MatAtBread/FreeHouse-TRV-1.0/hardware/TRV1-BH/Spacer-retainer-plug.step

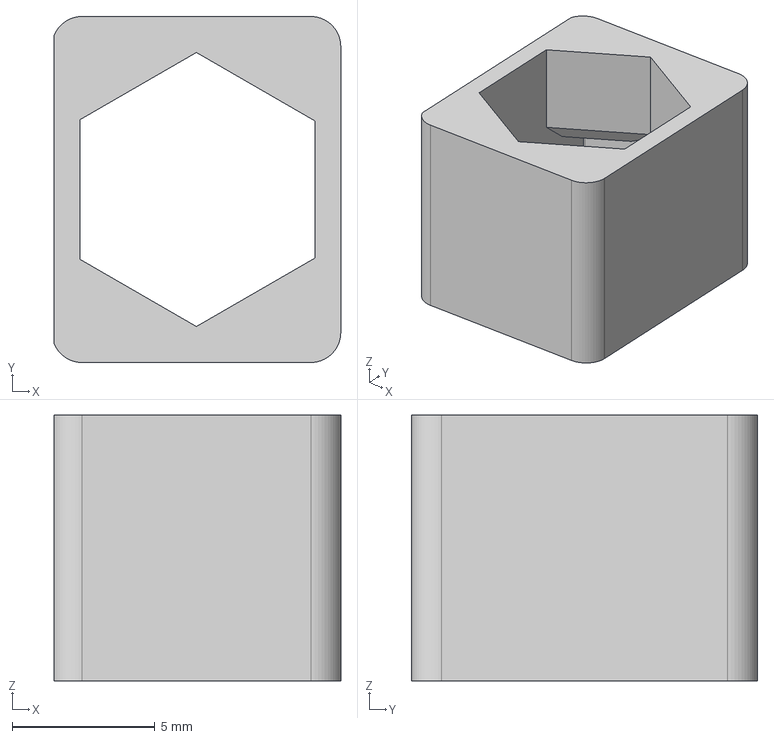
[picture p1: CAD file, 2026-05-30]
hardware/TRV1-BH/Spacer-retainer-plug.step
10.0 x 12.1 x 9.30 mm
