MatAtBread/FreeHouse-TRV-1.0/hardware/TRV1-CR123/Base p10-h1-r2-steel.step

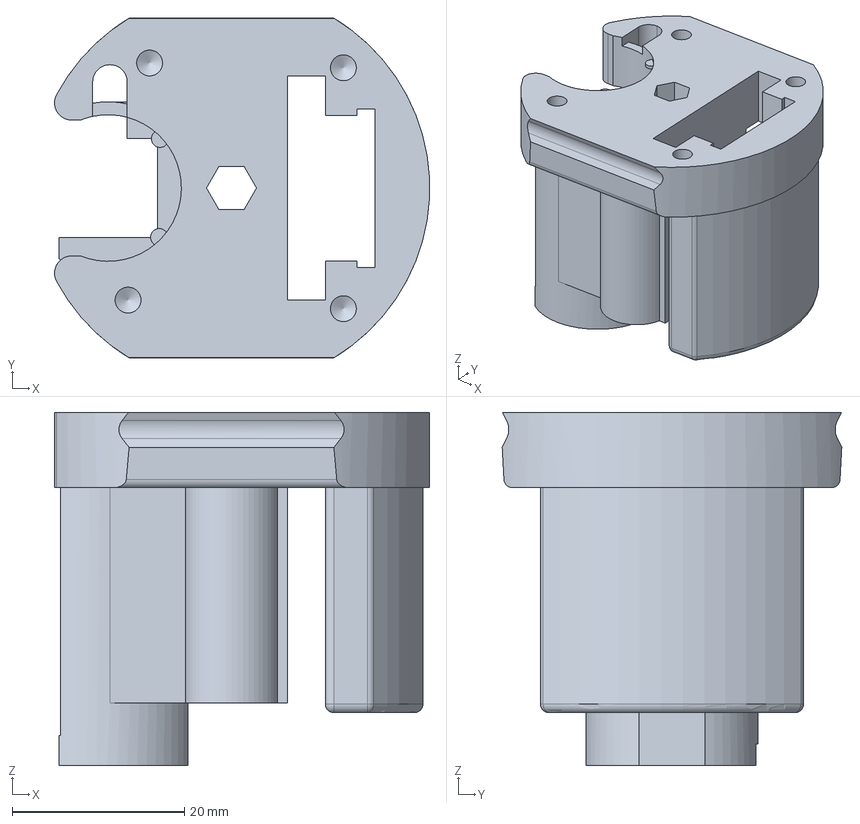
[picture p2: CAD file, 2025-10-17]
hardware/TRV1-CR123/Base p10-h1-r2-steel.step
43.5 x 39.4 x 41.0 mm
