MatAtBread/FreeHouse-TRV-1.0/hardware/TRV1-BH/Base.step

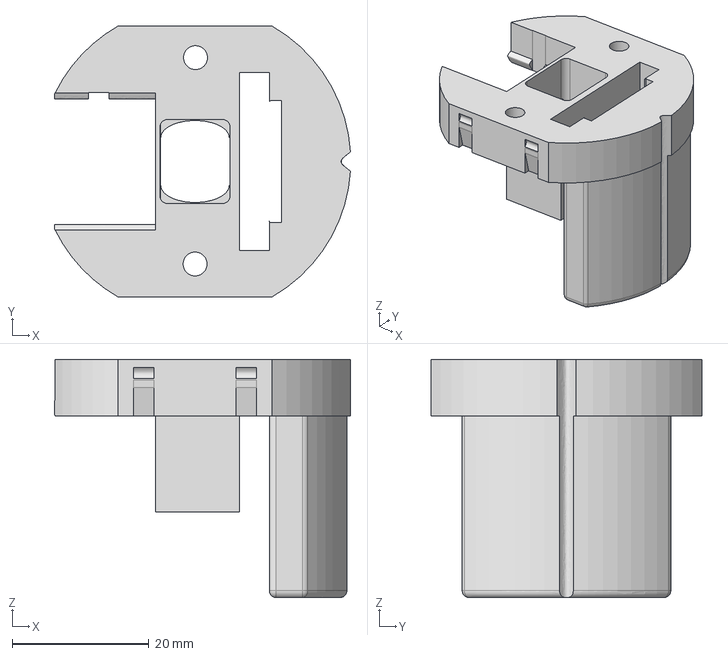
[picture p3: CAD file, 2026-05-30]
hardware/TRV1-BH/Base.step
43.3 x 39.6 x 34.9 mm
