MatAtBread/FreeHouse-TRV-1.0/hardware/TRV1-CR123/Case-r2.step

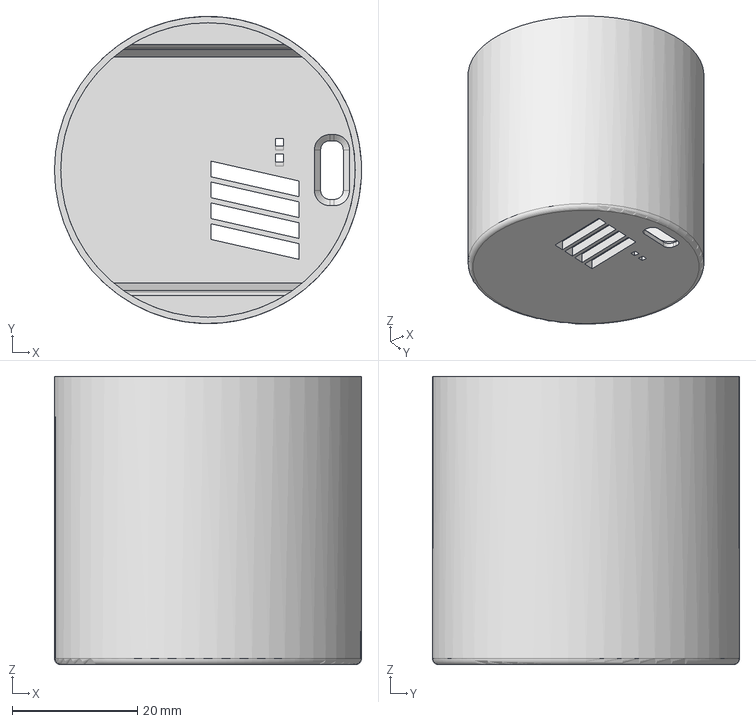
[picture p4: CAD file, 2025-05-19]
hardware/TRV1-CR123/Case-r2.step
49.0 x 49.0 x 46.0 mm
