MatAtBread/FreeHouse-TRV-1.0/hardware/TRV1-BH/Pin Coupler (2).step

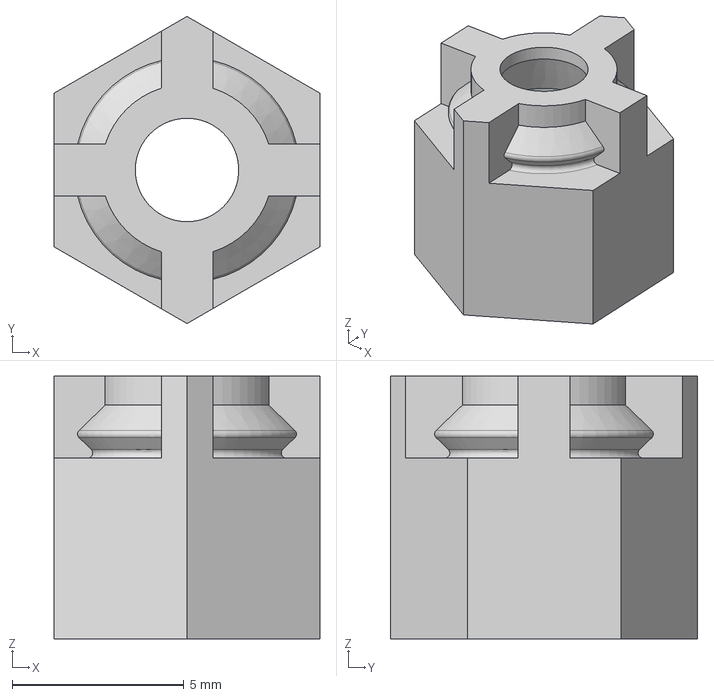
[picture p5: CAD file, 2026-05-30]
hardware/TRV1-BH/Pin Coupler (2).step
7.74 x 8.94 x 7.65 mm
