MatAtBread/FreeHouse-TRV-1.0/hardware/TRV1-BH/Batt holder.step

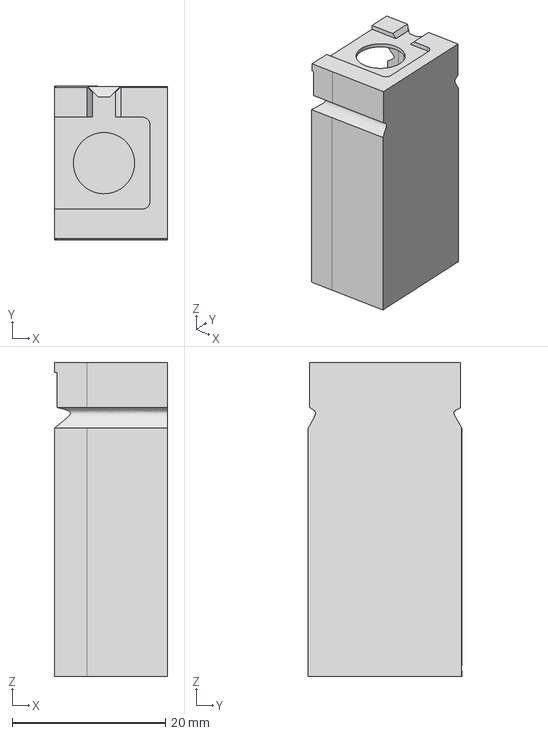
[picture p6: CAD file, 2026-05-30]
hardware/TRV1-BH/Batt holder.step
14.8 x 20.0 x 41.0 mm
