MatAtBread/FreeHouse-TRV-1.0/hardware/TRV1-BH/Valve coupler.step

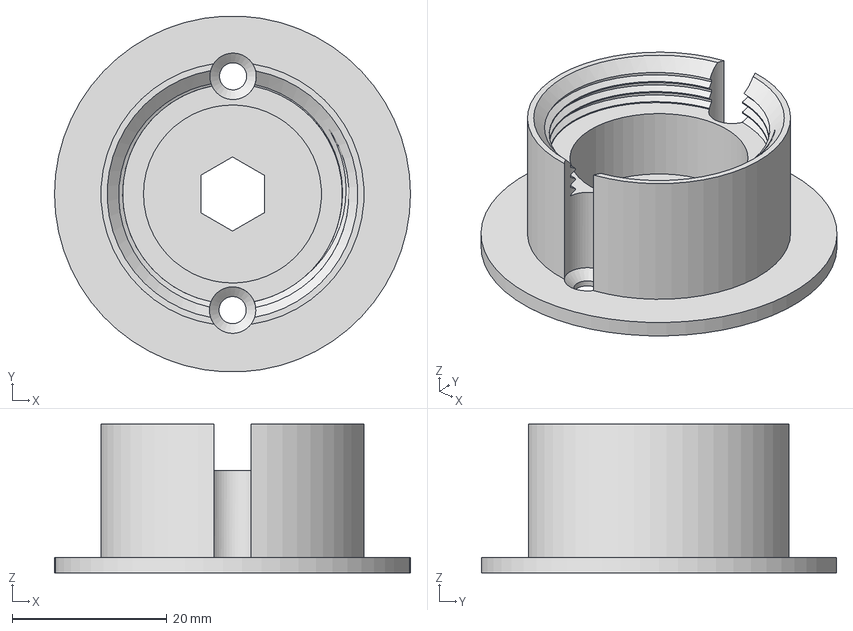
[picture p7: CAD file, 2026-05-30]
hardware/TRV1-BH/Valve coupler.step
46.0 x 45.9 x 19.2 mm
