MatAtBread/FreeHouse-TRV-1.0/hardware/TRV1-AA2/Pin Coupler.step

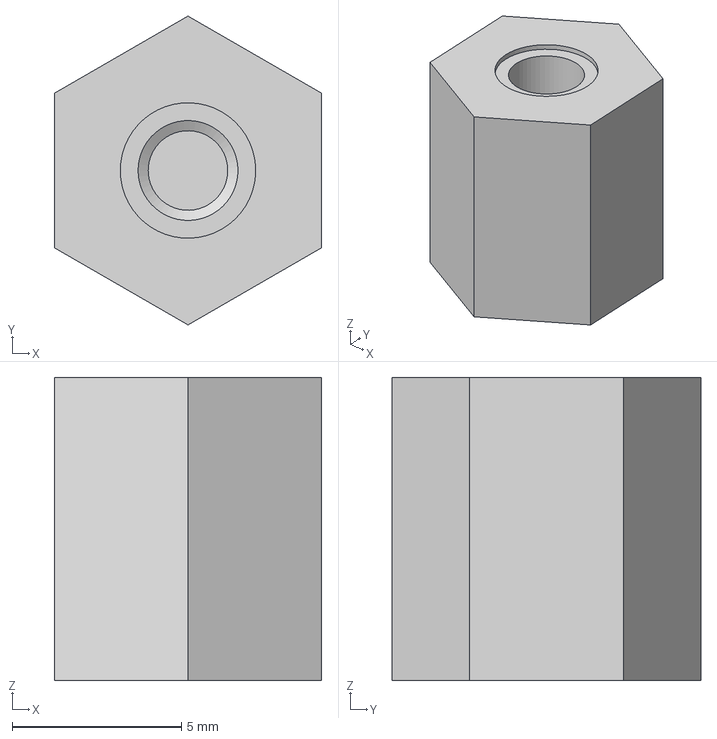
[picture p8: CAD file, 2026-04-09]
hardware/TRV1-AA2/Pin Coupler.step
7.90 x 9.12 x 8.95 mm
