MatAtBread/FreeHouse-TRV-1.0/hardware/TRV1-BH/Pin Couipler (2) cap.step

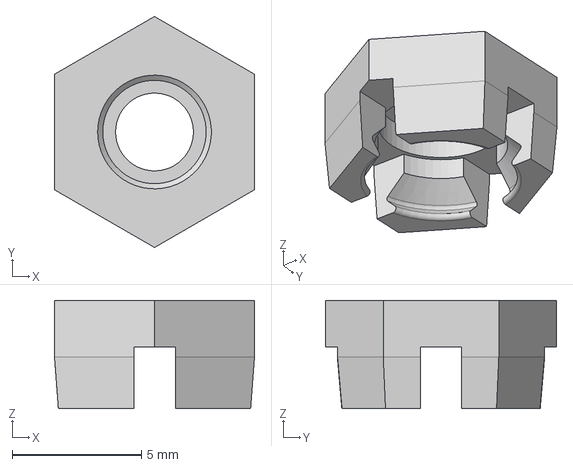
[picture p9: CAD file, 2026-05-30]
hardware/TRV1-BH/Pin Couipler (2) cap.step
7.74 x 8.94 x 4.19 mm
