MatAtBread/FreeHouse-TRV-1.0/hardware/TRV1-AA2/Case.step

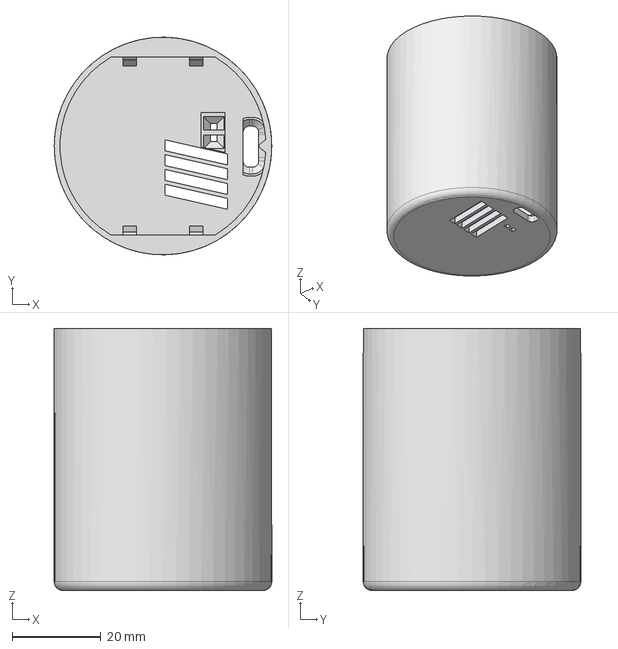
[picture p10: CAD file, 2026-04-09, an earlier design]
hardware/TRV1-AA2/Case.step
49.0 x 49.0 x 59.0 mm
