MatAtBread/FreeHouse-TRV-1.0/hardware/TRV1-AA2/Base.step

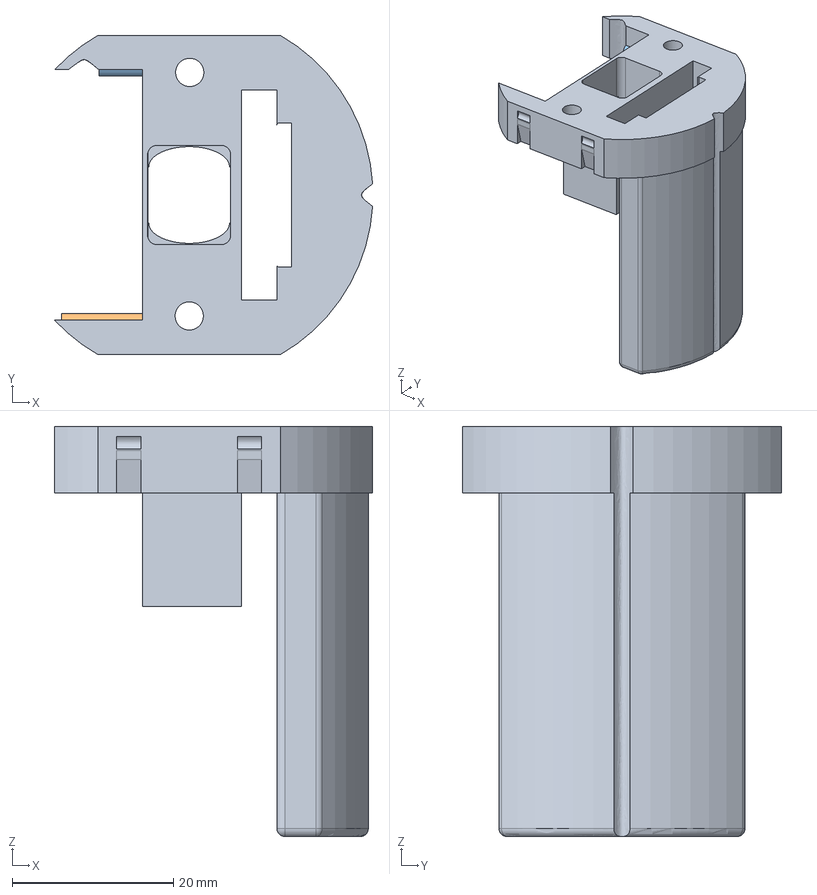
[picture p11: CAD file, 2026-04-09, an earlier design]
hardware/TRV1-AA2/Base.step
39.5 x 39.6 x 50.9 mm
