MatAtBread/FreeHouse-TRV-1.0/hardware/TRV1-AA2/Batt holder.step

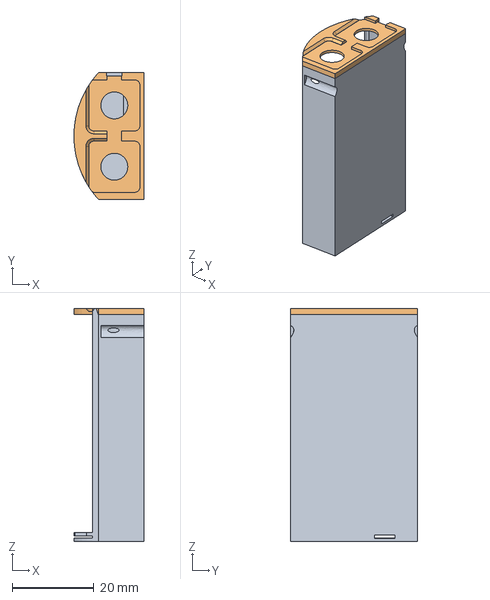
[picture p12: CAD file, 2026-04-09, an earlier design]
hardware/TRV1-AA2/Batt holder.step
17.2 x 31.0 x 57.0 mm
