MatAtBread/FreeHouse-TRV-1.0/(list of files, cad)

Other CAD files:
hardware/TRV1-CR123/Case-r1.step
hardware/TRV1-BH/Case.step
hardware/TRV1-NS/Spacer-retainer-plug.step
hardware/TRV1-NS/Valve coupler.step
hardware/TRV1-AA2/Valve coupler.step
hardware/TRV1-NS/Batt holder.step
hardware/TRV1-AA2/Spacer-retainer-plug.step
hardware/TRV1-NS/Case.step
