MatAtBread/FreeHouse-TRV-1.0/hardware/Schematic 3_2.pdf

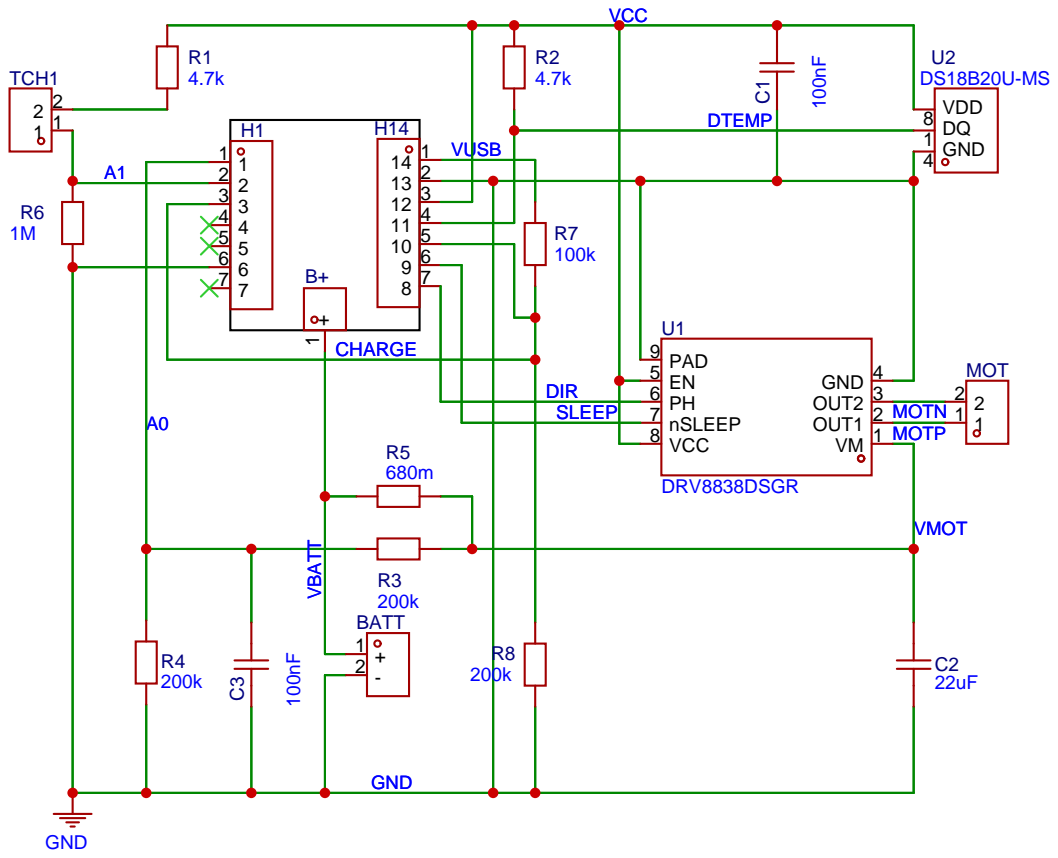
[picture p13: page 1]
