MatAtBread/FreeHouse-TRV-1.0/hardware/Schematic 3_1.pdf

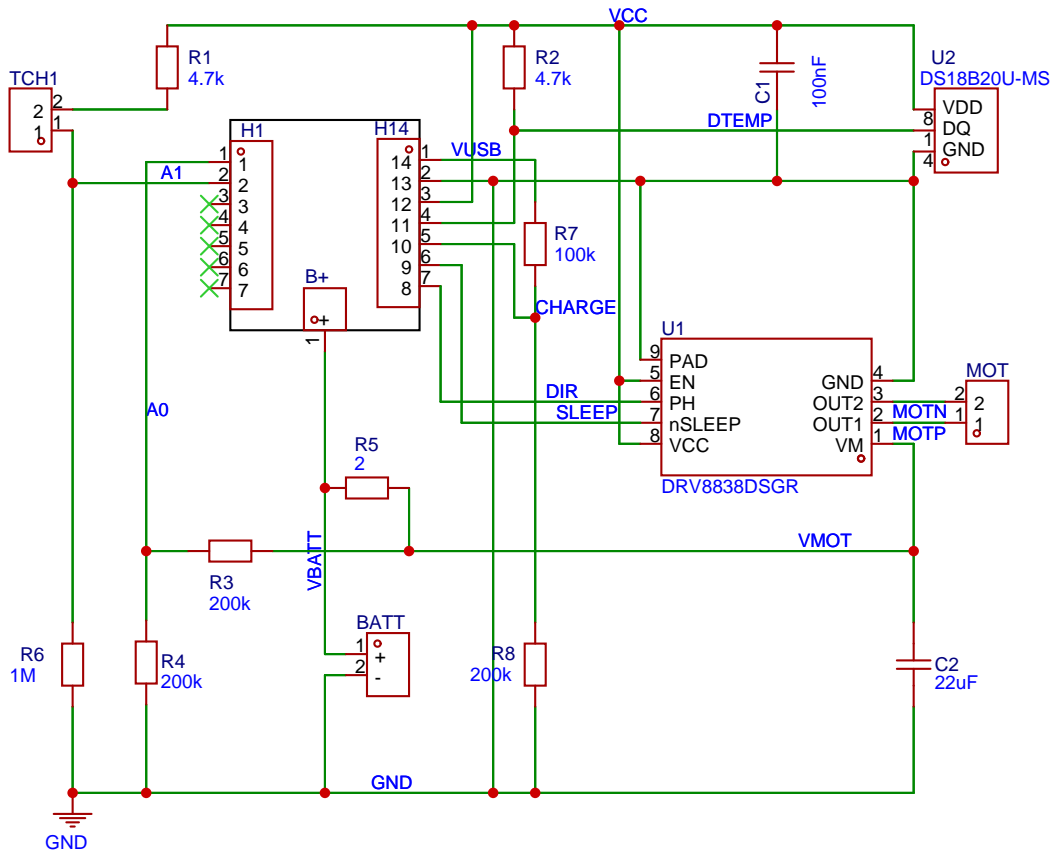
[picture p14: page 1]
