MatAtBread/FreeHouse-TRV-1.0/main/main.cpp

// the setup function runs once when you press reset or power the board

#include "gpio.hpp"
#include "esp_app_desc.h"
#include "esp_netif.h"
#include "esp_sleep.h"
#include "net/esp-now.hpp"
#include "nvs_flash.h"
#include "pins.h"
#include "src/CaptiveWifi.h"
#include "src/TouchButton.hpp"
#include "src/WithTask.hpp"
#include "src/trv-state.h"
#include "trv.h"

extern "C" {
const char *TAG = "TRV";
}

static RTC_DATA_ATTR int messageCheckCount = 0;
static RTC_DATA_ATTR int wakeCount = 0;
char versionDetail[110] = {0};
#define RECALIBRATE_PERIOD_SECS (24 * 3600 * 25) // Recalibrate every 25 days

uint32_t woken() {
  Trv trv; // Loads static state from FS
  if (trv.flatBattery() && !trv.is_charging()) {
    ESP_LOGW(TAG, "Battery exhausted");
    // Skip tidy up - we're dead
    esp_sleep_enable_ext1_wakeup(1ULL << TOUCH_PIN, ESP_EXT1_WAKEUP_ANY_HIGH);
    return 0x7FFFFFFF;
  }

  ESP_LOGI(TAG, "Build: %s. Wake: %d reset: %d count: %d", versionDetail,
           esp_sleep_get_wakeup_cause(), esp_reset_reason(), wakeCount);

  if (wakeCount > RECALIBRATE_PERIOD_SECS / trv.getConfig().sleep_time) {
    ESP_LOGI(TAG,
             "Recalibration period reached (%d secs), starting calibration",
             RECALIBRATE_PERIOD_SECS);
    trv.calibrate();
    wakeCount = 0;
  }

  EspNet net; // Start Wi-Fi based on Trv state (loaded above)

  uint32_t dreamSecs = 1;
  TouchButton touchButton;
  if (!trv.deviceName()[0] || touchButton.pressed() == PRESSED) {
    ESP_LOGI(TAG, "Touch button pressed / device name '%s'", trv.deviceName());
    CaptivePortal portal(&trv, trv.deviceName());
    switch (portal.exitStatus) {
    case exit_status_t::CALIBRATE:
      trv.calibrate();
      break;
    case exit_status_t::TEST_MODE:
      trv.testMode(touchButton);
      break;
    case exit_status_t::POWER_OFF:
      ESP_LOGI(TAG, "Power off requested");
      dreamSecs = 0x7FFFFFFF; // Forever
      EspNet::unpair();
      break;
    case exit_status_t::CLOSED:
    case exit_status_t::NONE:
    case exit_status_t::TIME_OUT:
      break;
    }
  } else {
    net.checkMessages(&trv);
    // We do this at 0 so it always sets the mode after a hard restart
    if (messageCheckCount == 0) {
      // Every 60 seconds re-set the system-mode to ensure the TRV acts to
      // correct things like motor time-outs or temperature changes
      trv.setSystemMode(trv.getConfig().system_mode);
    }

    int checkEvery = 60 / trv.getConfig().sleep_time;
    if (++messageCheckCount >= checkEvery)
      messageCheckCount = 0;

    dreamSecs = trv.getConfig().sleep_time;
  }

  while (WithTask::waitForAllTasks(1234) == TIMEOUT) {
    if (net.wait(1) != TIMEOUT) {
      net.sendStateToHub(&trv);
    }
  }
  net.sendStateToHub(&trv);

  if (trv.requiresNetworkControl()) {
    // We have to do this incase there's a pending OTA request executed by the
    // TRV desctructor The reason we don't always do this is to save power/time
    // when not needed
    net.deinit();
  }

  uint64_t ext1WakeMask = (1ULL << TOUCH_PIN);
  if (!trv.is_charging()) {
    // Ideally, we'd wake on CHARGING changed, but in the current h/w this is
    // not an RTC_GPIO. On Rev3.2, the CHARGING pin is connected to GPIO2, so we
    // can use that if we're not alreday charghing (if we are, it would wake
    // immediately)
    ext1WakeMask |= (1ULL << 2);
  }

  // Prepare to sleep. Wake on touch or timeout
  // Ideally, we'd wake on CHARGING changed, but in the current h/w this is not
  // an RTC_GPIO. On Rev3.2, the CHARGIBG pin is connected to GPIO2, so we can
  // use that.
  esp_sleep_enable_ext1_wakeup(ext1WakeMask, ESP_EXT1_WAKEUP_ANY_HIGH);

  return dreamSecs;
}

extern "C" void app_main() {
  GPIO::pinMode(LED_BUILTIN, OUTPUT);
  GPIO::digitalWrite(LED_BUILTIN, false);

  wakeCount += 1;

  const auto app = esp_app_get_description();
  snprintf((char *)versionDetail, sizeof versionDetail, "%s %s %s",
           app->version, app->date, app->time);

  esp_err_t ret = nvs_flash_init();
  if (ret == ESP_ERR_NVS_NO_FREE_PAGES ||
      ret == ESP_ERR_NVS_NEW_VERSION_FOUND) {
    ESP_ERROR_CHECK(nvs_flash_erase());
    ret = nvs_flash_init();
  }
  ESP_ERROR_CHECK(ret);
  ESP_ERROR_CHECK(esp_netif_init());
  ESP_ERROR_CHECK(esp_event_loop_create_default());

  auto dreamSecs = woken();

  GPIO::digitalWrite(LED_BUILTIN, true);
  GPIO::pinMode(TOUCH_PIN, INPUT);

  esp_sleep_enable_timer_wakeup(dreamSecs * 1000000ULL);
  ESP_LOGW(TAG,
           FREEHOUSE_MODEL
           " (build %s) device '%s' dbg=0x%04x. Deep sleep %u secs\n",
           versionDetail, Trv::deviceName(), debugFlag(DEBUG_ALL), dreamSecs);

  esp_deep_sleep_start();
}
