MatAtBread/FreeHouse-TRV-1.0/main/src/board.cpp

#include "board.h"
#include "gpio.hpp"

#include "nvs.h"

esp_err_t dev_wifi_init(wifi_init_config_t *config) {
    GPIO::pinMode(3, OUTPUT);
    GPIO::pinMode(14, OUTPUT);
    GPIO::digitalWrite(3, 0);
    GPIO::digitalWrite(14, 0);

    // If NVS is not initialized, disable NVS in WiFi config to prevent errors
    nvs_handle_t check_handle;
    if (nvs_open("storage", NVS_READONLY, &check_handle) == ESP_ERR_NVS_NOT_INITIALIZED) {
        ((wifi_init_config_t*)config)->nvs_enable = 0;
    } else {
        nvs_close(check_handle);
    }

    auto err = esp_wifi_init(config);
    if (err == ESP_OK) {
        wifi_country_t country = {
        .cc = "GB",
        .schan = 1,
        .nchan = 13,
        .policy = WIFI_COUNTRY_POLICY_MANUAL
        };
        err = esp_wifi_set_country(&country);
    }
    return err;
}

esp_err_t dev_wifi_deinit(void) {
    GPIO::pinMode(3, INPUT);
    GPIO::pinMode(14, INPUT);
    return esp_wifi_deinit();
}
