MatAtBread/FreeHouse-TRV-1.0/main/pins.h

#include "hal/gpio_types.h"

#define MOTOR     (gpio_num_t)17  // D7
#define NSLEEP    (gpio_num_t)19  // D8
#define CHARGING  (gpio_num_t)20  // D9
#define DTEMP     (gpio_num_t)18  // D10
#define BATTERY   (gpio_num_t)0   // A0
#define TOUCH_PIN (gpio_num_t)1   // A1
#define LED_BUILTIN (gpio_num_t)15
