MatAtBread/FreeHouse-TRV-1.0/main/src/MotorController.h

#ifndef MOTOR_CONTROLLER_H
#define MOTOR_CONTROLLER_H

#include "BatteryMonitor.h"
#include "WithTask.hpp"

typedef struct motor_params_s {
  bool reversed;
  int backoff_ms;
  int stall_ms;
} motor_params_t;

class MotorController: public WithTask {
 protected:
  BatteryMonitor* battery;
  volatile uint8_t target;
  volatile uint8_t& current;
  motor_params_t& params;
  volatile bool calibrating = false;

  void setDirection(int dir);

 public:
  MotorController(BatteryMonitor* battery, uint8_t& current, motor_params_t &params);
  virtual ~MotorController();
  void task();
  int getDirection();
  void setValvePosition(int pos /* 0-100, -1 means "current position - stop the motor now" */);
  uint8_t getValvePosition();
  void calibrate();
  static const char* lastStatus;
};

#endif
