MatAtBread/FreeHouse-TRV-1.0/main/src/NetMsg.cpp

#include "esp_log.h"

#include "helpers.h"

#include "string.h"
#include "trv-state.h"
#include "trv.h"
#include "gpio.hpp"
#include "cJSON.h"

extern const char *systemModes[];

#define FIELD(N) static const char field_##N[] = #N;

FIELD(current_heating_setpoint);
FIELD(local_temperature_calibration);
FIELD(system_mode);
FIELD(sleep_time);
FIELD(resolution);
FIELD(backoff_ms);
FIELD(stall_ms);
FIELD(motor_reversed);
FIELD(debug_flags);
FIELD(unpair);
FIELD(calibrate);

const char* Trv::writeable[] = {
    field_current_heating_setpoint,
    field_local_temperature_calibration,
    field_system_mode,
    field_sleep_time,
    field_resolution,
    field_backoff_ms,
    field_stall_ms,
    field_motor_reversed,
    field_debug_flags,
    field_unpair,
    field_calibrate,
    NULL
};

void Trv::processNetMessage(const char *json) {
  cJSON *root = cJSON_Parse(json);
  if (!root) {
    ESP_LOGW(TAG, "JSON parse failed: %s", json);
    return;
  }
  ESP_LOGI(TAG, "JSON message: %s", json);

  cJSON *current_heating_setpoint = cJSON_GetObjectItem(root, field_current_heating_setpoint);
  cJSON *local_temperature_calibration = cJSON_GetObjectItem(root, field_local_temperature_calibration);
  cJSON *system_mode = cJSON_GetObjectItem(root, field_system_mode);
  cJSON *sleep_time = cJSON_GetObjectItem(root, field_sleep_time);
  cJSON *debug_flags = cJSON_GetObjectItem(root, field_debug_flags);
  cJSON *resolution = cJSON_GetObjectItem(root, field_resolution);
  cJSON *stall_ms = cJSON_GetObjectItem(root, field_stall_ms);
  cJSON *backoff_ms = cJSON_GetObjectItem(root, field_backoff_ms);
  cJSON *motor_reversed = cJSON_GetObjectItem(root, field_motor_reversed);
  cJSON *unpair = cJSON_GetObjectItem(root, field_unpair);
  cJSON *calibrate = cJSON_GetObjectItem(root, field_calibrate);

  auto unpairRequest = cJSON_IsTrue(unpair);
  auto calibrateRequest = cJSON_IsTrue(calibrate);

  if (cJSON_IsString(system_mode) && (system_mode->valuestring != NULL)) {
    for (esp_zb_zcl_thermostat_system_mode_t mode = ESP_ZB_ZCL_THERMOSTAT_SYSTEM_MODE_OFF;
         mode <= ESP_ZB_ZCL_THERMOSTAT_SYSTEM_MODE_SLEEP;
         mode = (esp_zb_zcl_thermostat_system_mode_t)(mode + 1)) {
      if (!strcasecmp(systemModes[mode], system_mode->valuestring)) {
        ESP_LOGI(TAG, "system_mode %s (%d)", system_mode->valuestring, mode);
        setSystemMode(mode);
      }
    }
  }

  if (cJSON_IsNumber(current_heating_setpoint)) {
    setHeatingSetpoint((float)current_heating_setpoint->valuedouble);
  }

  if (cJSON_IsNumber(local_temperature_calibration)) {
    setTempCalibration((float)local_temperature_calibration->valuedouble);
  }

  if (cJSON_IsNumber(sleep_time)) {
    setSleepTime(sleep_time->valueint);
  }
  if (cJSON_IsNumber(debug_flags)) {
    setDebugFlags(debug_flags->valueint);
  }

  if (cJSON_IsNumber(resolution)) {
    int res = -1;
    if (resolution->valuedouble >= 0.5) res = 0;
    else if (resolution->valuedouble >= 0.25) res = 1;
    else if (resolution->valuedouble >= 0.125) res = 2;
    else res = 3;
    if (res >= 0 && res <= 3)
      setTempResolution(res);
  }

  motor_params_t motor = {
    .reversed = cJSON_IsBool(motor_reversed) ? (bool)cJSON_IsTrue(motor_reversed) : getConfig().motor.reversed,
    .backoff_ms = cJSON_IsNumber(backoff_ms) ? backoff_ms->valueint : -1,
    .stall_ms = cJSON_IsNumber(stall_ms) ? stall_ms->valueint : -1
  };
  setMotorParameters(motor);

  cJSON *ota = cJSON_GetObjectItem(root, "ota");
  if (cJSON_IsObject(ota)) {
    cJSON *url = cJSON_GetObjectItem(ota, "url");
    cJSON *ssid = cJSON_GetObjectItem(ota, "ssid");
    cJSON *pwd = cJSON_GetObjectItem(ota, "pwd");
    if (cJSON_IsString(url) && (url->valuestring != NULL)
      && cJSON_IsString(ssid) && (ssid->valuestring != NULL)
      && cJSON_IsString(pwd) && (pwd->valuestring != NULL)) {
        ESP_LOGI(TAG, "OTA URL: %s, Wifi %s", url->valuestring, ssid->valuestring);
        requestUpdate(url->valuestring, ssid->valuestring, pwd->valuestring) ;
    }
  }
  // Free the root object
  cJSON_Delete(root);

  if (calibrateRequest) {
    this->calibrate();
  }
  if (unpairRequest) {
    doUnpair();
  }
}
