MatAtBread/FreeHouse-TRV-1.0/main/src/TouchButton.hpp

#ifndef TOUCH_BUTTON_HPP
#define TOUCH_BUTTON_HPP

#include "trv.h"
#include "WithTask.hpp"
#include "gpio.hpp"
#include "esp_log.h"
#include "pins.h"

// Sample the touch ADC for up to 420ms to see if it was touched for the whole
// second. Bails returning false if it was released/not touched during that
// period.
typedef enum { WAIT, PRESSED, NOT_PRESSED } TouchState;

class TouchButton : protected WithTask {
protected:
  TouchState state = WAIT;

  void task() {
    for (int i = 0;; i++) {
      auto n = GPIO::analogRead(TOUCH_PIN);
      ESP_LOGI("TRV", "Touch test %d", n);
      if (n >= 0 && n < 512) {
        state = NOT_PRESSED;
        return;
      }
      if (i == 6) {
        ESP_LOGI("TRV", "Touch button pressed");
        state = PRESSED;
        return;
      }
      delay(70);
    }
  }

public:
  TouchButton() { StartTask(TouchButton); }
  bool pressed() {
    wait();
    return state == PRESSED;
  };
  void reset() {
    wait();
    state = WAIT;
    StartTask(TouchButton);
  }
};

#endif
