MatAtBread/FreeHouse-TRV-1.0/(commit log)

2025-03-04 With ZB partition
    [partitions.csv]
2025-03-04 Move Arduino project to ESP-IDF
    [partitions.csv]
2025-04-21 Implement ROTA
    * "ota" member contains wifi+root creds
    * Improve esp-now to select the hub with the best rssi
    * Implement http OTA
    * Generalize NetMsg to allow for other transports
    * Fix de-init in WiFiStation
    [NetMsg.cpp, main.cpp, wifi-sta.cpp, wifi-sta.hpp]
2025-04-21 Flicker LED during ROTA
2025-04-22 Optimize. Remove unused components. Increase "main" stack size. Log to JTAG+UART
2025-04-24 Re-order TRV sensor init to minimize wait times
2025-04-24 Add build version to PAIR info
    [Base.stl]
2025-04-25 Add mcu_temperature
    Note: Uses uncalibrated mcu temp as esp32c6 calibration appears undefined in many cases. See mcu_temp.c for possible solution
2025-04-25 Make ssystems modes case insensitive
2025-04-27 Add Rev2 h/w files. Change sleep to 20 seconds
    [BOM_FreeHouse TRV 2.0_PCB_2025-04-27.xlsx, Base.3mf, PickAndPlace_PCB_2025-04-27.xlsx]
2025-04-29 Correct camelCase json fields
    [CaptiveWifi.cpp, trv-state.cpp, trv-state.h]
2025-04-29 Account for charging bias in battery->getPercent
2025-05-05 Use running average temp. Separate between sensor_ and local_temperature. Use versioning for nvs state. Add SoftWatchDog logging.
    [Base.step, Batt+ve.step, Case.step, Fixing.step, Link Nut.step]
2025-05-05 Avoid NPE. Correct timeout test in SoftWatchDog
    [NetMsg.cpp, WithTask.cpp]
2025-05-10 Make "sleep" stop the motor. Update 3D files
    [Base.step, Batt+ve.step, Case.step, Fixing.step, Link Nut.step]
2025-05-10 Rationalise 3D models
    [BOM_FreeHouse TRV 2.0_PCB_2025-04-27.xlsx, Base p10-1.step, Base.3mf, Base.step, Base.stl, Case.step, Case.stl, Fixing.step]
2025-05-11 Tidy up logging
    [Base p10-1.step]
2025-05-13 Enable Xiao ESP32C6 RF switch on wifi
    [Base p10-1.step, Motor retainer.step]
2025-05-14 Update 3D files
    [Base p10-1-r2.step, Base p10-1.step, Base p10-h1-r2.step, Case-r2.step, Case.step, Fixing-h1.step, Fixing-h3.step, Link Nut.step]
2025-05-19 Permit single quotes in web input, but not dbl quotes
    [Base p10-h1-r1.step, Case-r1.step, Fixing-h1.step]
2025-05-19 Updated 3D files
    [Base p10-1-r2.step, Base p10-h1-r2.step, Case-r2.step, Case.step]
2025-05-22 Report rx rssi frome device (alongside tx rssi from hub)
2025-06-10 Implement variable sleep_time
    [Fixing-outer.step, Link Nut-outer.step]
2025-06-11 Add "writeable" to info. Fix up channel changing
    [NetMsg.cpp, main.cpp, trv-state.cpp]
2025-09-20 Update Link But-outer
    [Link Nut-outer.step]
2025-10-11 Implement resolution API
    NB: Doesn't actually set the DS18B20 resolution, due to some unknown issue. About to try a different DS18B20 component
    [BOM_FreeHouse TRV 3.0_PCB_2025-10-05.xlsx, BOM_FreeHouse TRV 3.1_PCB_2025-10-09.xlsx, Base p10-h1-r2.step, PickAndPlace_PCB_2025-10-05.xlsx, PickAndPlace_PCB_2025-10-09.xlsx]
2025-10-11 Set resolution working on SOME DS18B20 devices, but not all.
2025-10-11 Thicker base
    [Fixing-outer.step]
2025-10-17 Add h/w files for latest rev
    [Base p10-h1-r2-steel.step, Fixing-outer-steel.step, Motor retainer.step]
2025-10-21 Remove old h/w files. Export STEP for 2.3mm & 3mm plungers
    [Base p10-h1-r1.step, Base p10-h1-r2.step, Base.3mf, Base.step, Base.stl, Case.step, Case.stl, Fixing-h1.step]
2025-11-10 Fix warrings. Centralisde devcie model. Forgive bad temp resolution. Update h/w files
    [Base.step, Case.step, Fixing-outer.step, Link Nut-outer.step, Motor retainer.step]
2025-11-18 Update H/W 3D
    [3mm steel plunger.3mf, Base.step, Case.step, Fixing-outer.step, Link Nut-outer.step, Motor retainer.step]
2025-11-18 Lower stall ratio for 0R66
    [MotorController.cpp]
2025-11-20 H/w £D updates
    [Base.step, Case.step, Fixing-outer.step, Link Nut-outer.step, Motor retainer.step]
2025-11-23 h/w rev 3B
    [Bambu Project.3mf, Base.step, Case.step, Fixing-outer.step, Link Nut-outer.step, Motor retainer.step, Plunger.step]
2025-12-02 Update 3D models
    [Bambu Project.3mf, Base.step, Case.step, Fixing-outer.step, Link Nut-outer.step, Motor clip.step, Motor housing.step, Motor retainer.step]
2025-12-02 Add motor parameters. Tidy up CaptivePortal
2025-12-03 Use esp_backtrace. Disable motor disconnect detection. Show temp in test cycle
    [Base.step, Case.step, Fixing-outer.step, Link Nut-outer.step, Motor clip.step, Motor housing.step, Plunger Nut v1.step, Plunger.step]
2025-12-03 Correct current mA calc
    [MotorController.cpp]
2025-12-04 Tidy up MotorController logging
2025-12-04 Update h/w files
    [Base.step, Batt clip.step, Case.step, Fixing-outer.step, Link Nut-outer.step, Motor clip.step, Motor housing.step, Plunger Nut v1.step]
2025-12-05 Rev 3E h/w. Use common JSON key strings
    [Base.step, Batt clip.step, Batt holder.step, Case.step, Fixing-outer.step, Link Nut-outer.step, Motor clip.step, Motor housing.step]
2025-12-05 Ease lower batt clip
    [Base.step, Batt holder.step, Case.step, Fixing-outer.step, Link Nut-outer.step, Motor clip.step, Motor housing.step, Plunger.step]
2025-12-07 H/W Rev F
    [Base.step, Batt holder.step, Case.step, Fixing-outer.step, Link Nut-outer.step, Motor clip.step, Motor housing.step, Plunger-L.step]
2025-12-07 Catch DS18B20 errors...
    Set default motor threshold to 15ohms
    Set default minMotorTime to 500ms
    Poll motor R faster (40ms)
    Nicer MotorController logging
    Stop test on failure
    [DallasOneWire.cpp, MotorController.cpp, gpio.cpp, main.cpp, trv-state.cpp]
2025-12-07 Correct Trv desctuction order. Enable backtrace
    [trv-state.cpp]
2025-12-08 H/W rev F, PCB rev 3.2
    [BOM_FreeHouse TRV 3.2_PCB_2025-12-08.xlsx, Base.step, Batt holder.step, Case.step, Fixing-outer.step, Link Nut-outer.step, Motor clip.step, Motor housing.step]
2025-12-09 Make motor params active
2025-12-10 Update h/w for rev F
    [Base.step, Batt holder.step, Case.step, Fixing-outer.step, Link Nut-outer.step, Motor clip.step, Motor housing.step, Plunger-L.step]
2025-12-10 Better error handling in DallasOneWire
    [DallasOneWire.cpp, onewire.h, ow_init.c, ow_reset.c, ow_romsearch.c]
2025-12-15 Move build-info to esp-idf. Calibrate MotorController & smooth batt readings
2025-12-19 Update h/w cad
    [Base.step, Batt holder.step, Case.step, Fixing-outer.step, Link Nut-outer.step, Motor clip.step, Motor housing.step, Plunger-2.3mm.step]
2025-12-19 Use PWM for NSLEEP
    initaiily with minimal slow-start (560ms ramp from 78%->100%)
2025-12-19 Add L1 h/w
    [Base.step, Batt holder.step, Case.step, Hex boss.step, Valve coupler.step]
2025-12-20 TRV1-L1 test with back-off
    [Base.step, Batt holder.step, Case.step, Hex boss.step, Valve coupler.step]
2025-12-20 Remove DC motor load from config (unused by shunt calcs)
2025-12-20 Remove dc_motor parameter (unused)
    [Base.step, Batt holder.step, Case.step, Hex boss.step, Valve coupler.step]
2025-12-21 Remove shake. Replace with exit. Don't force valve pos on reset.
    [CaptiveWifi.cpp, MotorController.cpp, trv-state.cpp]
2025-12-22 Use avgAvg to track stall voltage as battery discharges
    [MotorController.cpp]
2025-12-22 Implement valve calibration
2025-12-23 L1 Hardware
    [Base.step, Batt holder.step, Case.step, Hex boss.step, Valve coupler.step]
2025-12-23 Calibrate based on mxaxMotor time (forces hard stall for thresholds)
    [MotorController.cpp, MotorController.h, trv.h]
2025-12-23 Use different stall strategies for T & L models
    [MotorController.cpp, trv-state.h, trv.h]
2025-12-24 Preserve & check motor calibration values, and auto-calibrate if necessary on startup
2025-12-24 Only check valve state if not opening the portal
2025-12-24 Fix OTA update order (always before shutdown)
    [NetMsg.cpp, trv-state.cpp, trv-state.h, update.cpp]
2025-12-26 Update h/w
    [Base.step, Batt holder.step, Case.step, Hex boss.step, Valve coupler.step]
2025-12-27 Global pins.h & add motor params
2025-12-30 Re-factor stall detection
    Use moving peak detection window.
    [BatteryMonitor.cpp, BatteryMonitor.h, CaptiveWifi.cpp, MotorController.cpp, MotorController.h, NetMsg.cpp, trv-state.cpp]
2025-12-31 Fiddle with maxMotorTime (doesn't respect BUILD_FREEHOUSE_MODEL?) and calibrate valve at startup (not wake)
    [MotorController.cpp, MotorController.h, trv-state.cpp]
2026-01-01 Record MotorController::lastStatus. Detect "stuck" state. Greater "sag" leeway
    [CaptiveWifi.cpp, MotorController.cpp, MotorController.h, trv-state.cpp]
2026-01-01 Fix STALL_MS_DEFAULT
2026-01-01 Fix JSON "motor" (string type)
    [trv-state.cpp]
2026-01-01 Retain and initialise MotorController::lastStatus
2026-01-01 Fix race in WithTask
    [MotorController.cpp, WithTask.cpp]
2026-01-03 Avoid setValvePosition test so motor reversal works
    [MotorController.cpp, main.cpp, trv-state.cpp]
2026-01-05 Apply state even if unchanged
    This will attempt subsequent valve movements if the target wasn't reached
2026-01-10 Stall tracking tweak. (peakVgPercent)
    ...plus -NS hardware, placeholder for clock switching.
    [Base.step, Batt holder.step, Case.step, Non-spring pin coupler v2.step, Valve coupler.step]
2026-01-14 Update NS hardware
    [Base.step, Batt holder.step, Case.step, Non-spring pin coupler v3.step, Spacer-retainer-plug.step, Valve coupler.step]
2026-01-14 Optimize away NVS operations on deep-sleep-wake
    ...only use NVS after a cold boot
    Initialize sensors in all boot scenarios and explicitly set the motor position on a cold boot (since there is no physical sensor for its position)
2026-01-15 Fix WithTask race. Restore nvs_flash_init as esp32c6 doesn't support PHY calbration in IRAM
    [Base.step, Batt holder.step, Case.step, Non-spring pin coupler v3.step, Non-spring pin coupler v4.step, Spacer-retainer-plug.step, Valve coupler.step]
2026-01-17 Update NS h/w
    [Base.step, Batt holder.step, Case.step, Non-spring pin coupler v4.step, Pin Coupler.step, Spacer-retainer-plug.step, Valve coupler.step]
2026-01-17 Init optimzations
    * Move TouchButton to i's own file
    * Create Trv::testMode().
    * Separate Trv state restoration (in constructor) from sensor/control initialisation to allow EspNet to be created early. Ensure routines call Trv::wait() if necessary
    * Avoid double calibration by having secondary consumers wait untilk the current calibration is finished
    * Log task execution times
    [Base.step, Batt holder.step, Case.step, Pin Coupler.step, Spacer-retainer-plug.step, Valve coupler.step]
2026-01-18 Introduce SyncTask to make switching between sync/async easy for test/dev
2026-01-18 Optimisation
    * Add debug_flags condfig.
    * Expose synchronous globalConfig for fast battery tests
    * Equalize task prioirty but add short delay to McuTempSensor to defer execution
    * Retain trv memebr of EspNet to permit slow/second packet receive
    * Fix scope issue in app_main/woken to enforce destructors
    [CaptiveWifi.cpp, DallasOneWire.cpp, MotorController.cpp, NetMsg.cpp, main.cpp, mcu_temp.cpp]
2026-01-19 Add "calibrate" JSON action
2026-01-22 Change batt off to 3200mV.
    [Case.step, TRV1-NS Case.3mf, TRV1-NS.3mf]
2026-01-22 Clear pairing on power-off
2026-01-22 Add v3.2 schematic
2026-01-23 Update 3D h/w
    [Base.step, Batt holder.step, Case.step, Pin Coupler.step, Spacer-retainer-plug.step, Valve coupler.step]
2026-01-23 Prevent tasks from running twice
    This big was introducted by an AG refactor a while ago
    [MotorController.cpp, WithTask.cpp, WithTask.hpp]
2026-01-23 Avoid local copy of config.system-mode to ensure network changes are reported
    [main.cpp, trv-state.cpp]
2026-01-23 Update defaults for TRV1-NS with 1:100 gearbox
2026-01-23 saveState() & nicer LED on update
2026-01-30 Recalibrate at least every 25 days to stop the valve sticking
2026-01-30 Correct disconnect on esp-now send fail. Unpair only if from current hub
2026-04-09 TRV1-AA2 3D files
    [Base.step, Batt holder.step, Case.step, Pin Coupler.step, Spacer-retainer-plug.step, Valve coupler.step]
2026-05-09 Log low-level battery info
2026-05-13 Tidy up hardware directory
    [3D_PCB_2025-10-17.step, BOM_FreeHouse TRV 3.0_PCB_2025-10-05.xlsx, BOM_FreeHouse TRV 3.1_PCB_2025-10-09.xlsx, BOM_FreeHouse TRV 3.2_PCB_2025-12-08.xlsx, BOM_Zigbee-TRV-SMD_2025-01-28.csv, Bambu Project.3mf, Base.step, Batt holder.step]
2026-05-30 Force DS18B20 DQ high during sleep
    [Base.step, Batt holder.step, Case.step, Pin Couipler (2) cap.step, Pin Coupler (2).step, Spacer-retainer-plug.step, Valve coupler.step]
